leanmcu/Green-Pill-Nano-Hardware/green_pill_nano_pinout.png

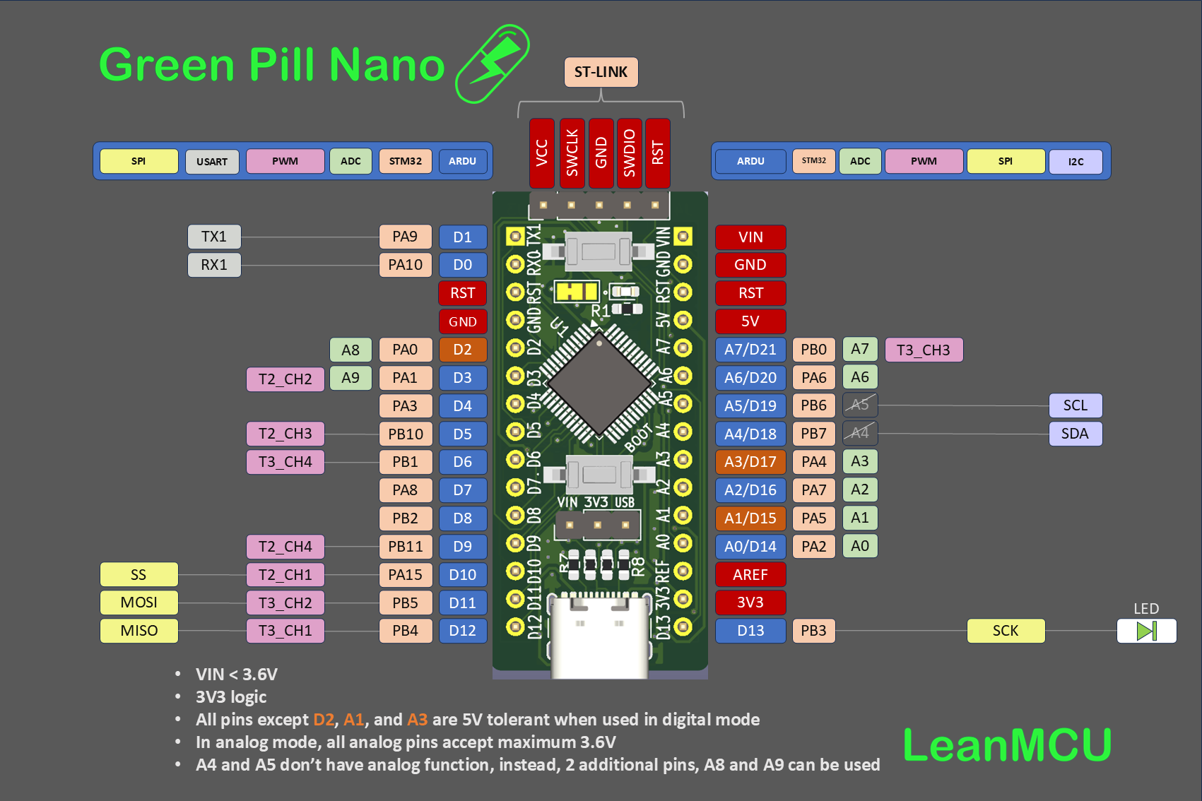
green_pill_nano_pinout.png
