leanmcu/Green-Pill-Nano-Hardware/green_pill_nano_schematic.pdf

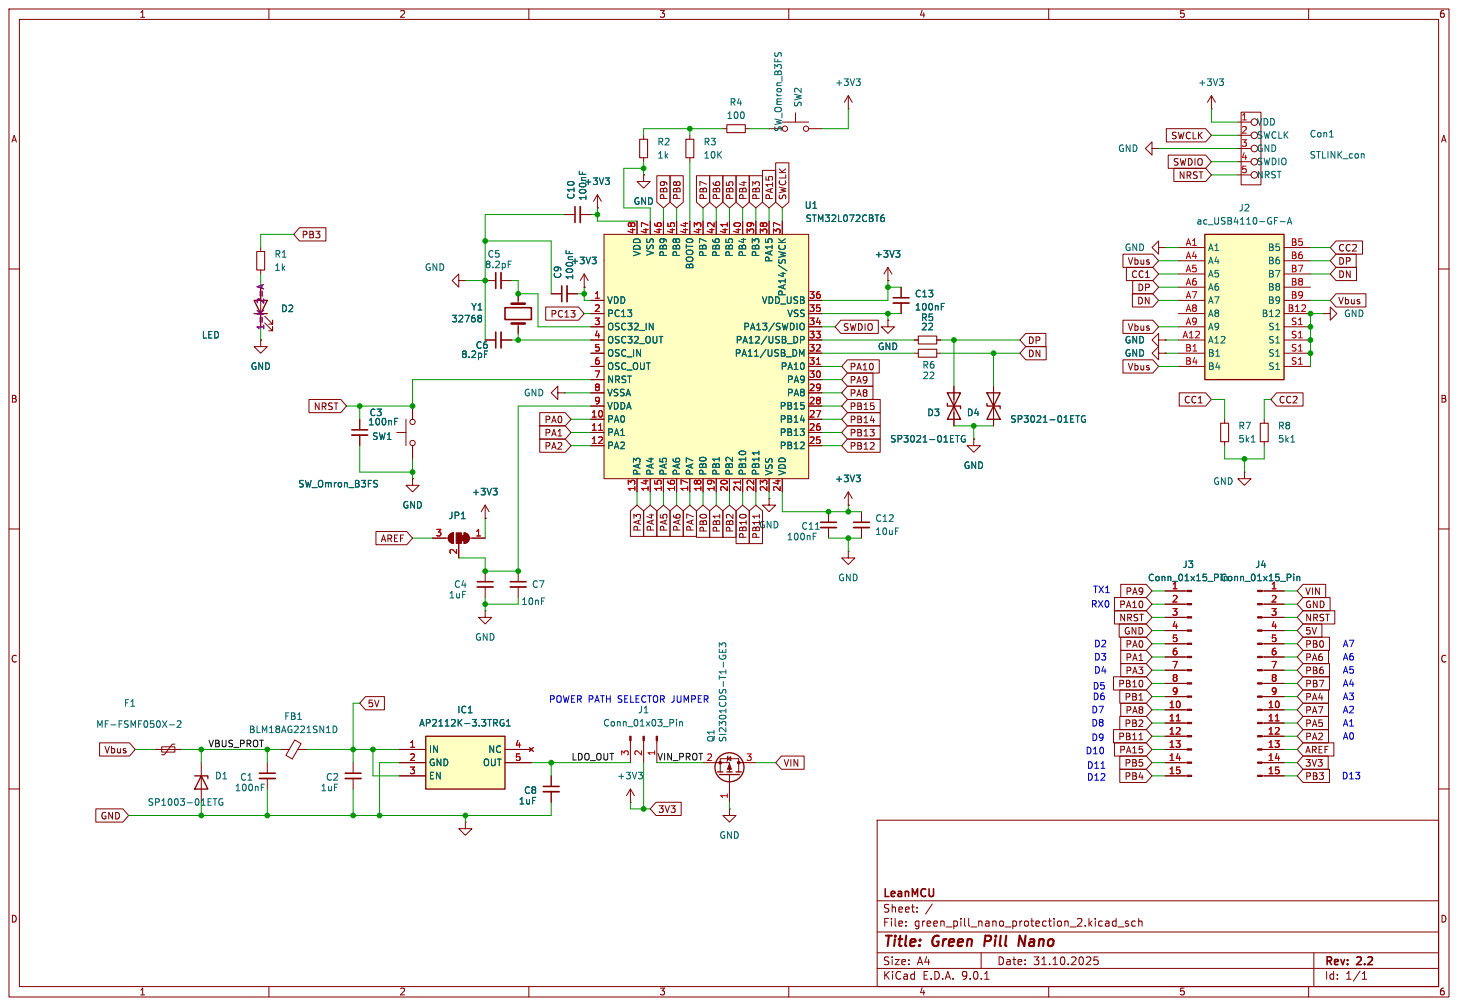
[picture p2: page 1]

Id: 1/1 Title: Green Pill Nano
