leanmcu/Green-Pill-Nano-Hardware/green_pill_nano_protection_2.kicad_sch

## KiCad design green_pill_nano_protection_2.kicad_sch (2026-01-22)

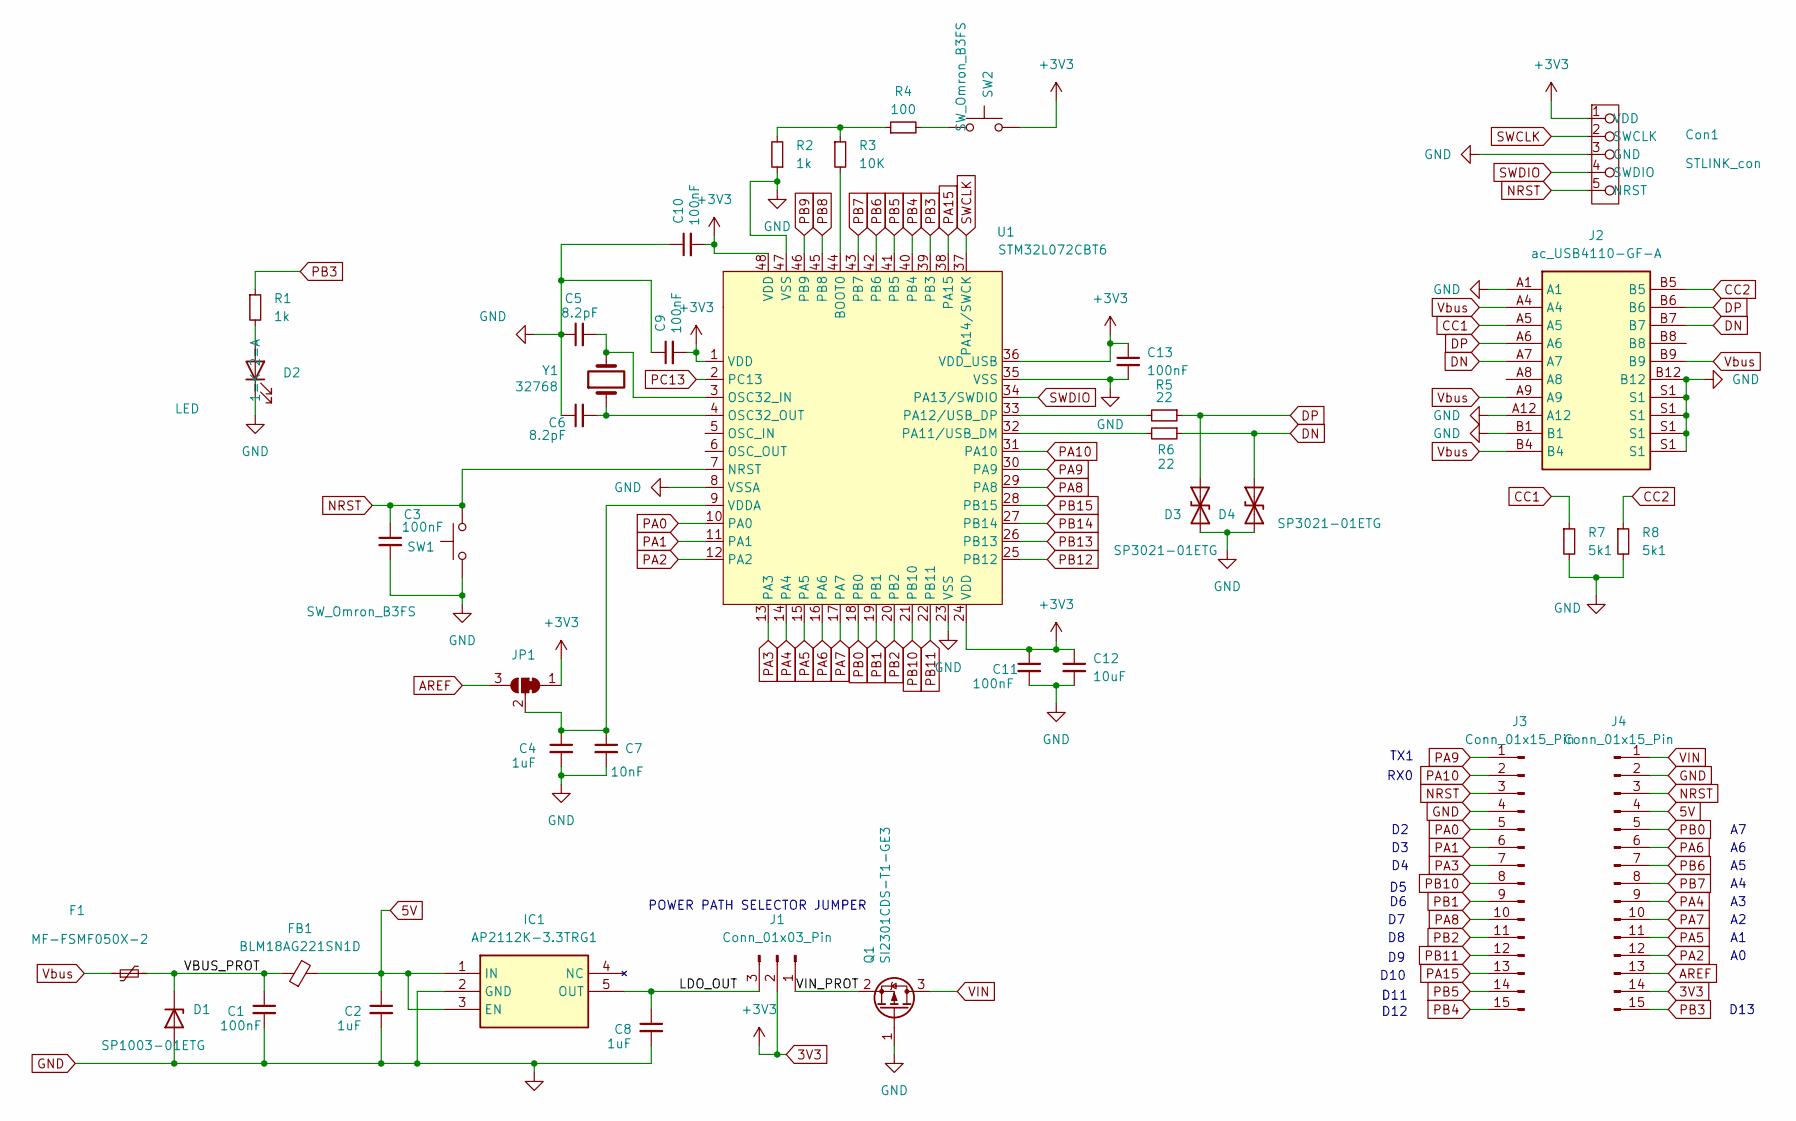
[picture p3: schematic green_pill_nano_protection_2.kicad_sch]

Parts:
C1, C3, C9, C10, C11, C13: 100nF; C_0603_1608Metric_Pad1.08x0.95mm_HandSolder
C2, C4, C8: 1uF; C_0603_1608Metric_Pad1.08x0.95mm_HandSolder
C5, C6: 8.2pF; C_0603_1608Metric_Pad1.08x0.95mm_HandSolder
C7: 10nF; C_0603_1608Metric_Pad1.08x0.95mm_HandSolder
C12: 10uF; C_0603_1608Metric_Pad1.08x0.95mm_HandSolder
Con1: STLINK_con; ac_PinHeader_1x05_P2.54mm_Vertical
D1: SP1003-01ETG; D_SOD-882
D2: LED; LED_0603_1608Metric
D3, D4: SP3021-01ETG; D_SOD-882
F1: MF-FSMF050X-2; R_0603_1608Metric_Pad0.98x0.95mm_HandSolder
FB1: BLM18AG221SN1D; R_0603_1608Metric_Pad0.98x0.95mm_HandSolder
IC1: AP2112K-3.3TRG1; SOT-23-5; Mouser Part Number 595-TPS7A0233PDBVR
J1: Conn_01x03_Pin; PinHeader_1x03_P2.54mm_Vertical
J2: ac_USB4110-GF-A; USB_C_Receptacle_GCT_USB4105-xx-A_16P_TopMnt_Horizontal; Mouser Part Number 640-USB4110-GF-A
J3, J4: Conn_01x15_Pin; PinHeader_1x15_P2.54mm_Vertical
JP1: SolderJumper_3_Bridged12; SolderJumper-3_P1.3mm_Bridged12_Pad1.0x1.5mm_NumberLabels
Q1: SI2301CDS-T1-GE3; SOT-23
R1, R2: 1k; R_0603_1608Metric_Pad0.98x0.95mm_HandSolder
R3: 10K; R_0603_1608Metric_Pad0.98x0.95mm_HandSolder
R4: 100; R_0603_1608Metric_Pad0.98x0.95mm_HandSolder
R5, R6: 22; R_0603_1608Metric_Pad0.98x0.95mm_HandSolder
R7, R8: 5k1; R_0603_1608Metric_Pad0.98x0.95mm_HandSolder
SW1, SW2: SW_Omron_B3FS; ac_tactile_switch_PTS636SP50SMTRLFS
U1: STM32L072CBT6; LQFP-48_7x7mm_P0.5mm
Y1: 32768; ac_quartz_FC135327680KAAG0

Connections:
5V: C2.1, FB1.2, IC1.1 (IN), IC1.3 (EN), J4.4
+3V3: C9.2, C10.2, C11.1, C12.1, C13.1, Con1.1 (VDD), J1.2, J4.14, JP1.1 (A), SW2.2, U1.1 (VDD), U1.24 (VDD), U1.36 (VDD_USB), U1.48 (VDD)
AREF: J4.13, JP1.3 (B)
CC1: J2.A5, R7.1
CC2: J2.B5, R8.1
DN: D4.1 (A1), J2.A7, J2.B7, R6.1
DP: D3.1 (A1), J2.A6, J2.B6, R5.1
GND: C1.2, C2.2, C3.2, C4.2, C5.1, C6.1, C7.2, C8.2, C9.1, C10.1, C11.2, C12.2, C13.2, Con1.3 (GND), D1.2 (A), D2.1 (K), D3.2 (A2), D4.2 (A2), IC1.2 (GND), J2.A1, J2.A12, J2.B1, J2.B12, J2.S1, J3.4, J4.2, Q1.1 (G), R2.1, R7.2, R8.2, SW1.1, U1.8 (VSSA), U1.23 (VSS), U1.35 (VSS), U1.47 (VSS)
LDO_OUT: C8.1, IC1.5 (OUT), J1.3
NRST: C3.1, Con1.5 (NRST), J3.3, J4.3, SW1.2, U1.7 (NRST)
unnamed: C4.1, C7.1, JP1.2 (C), U1.9 (VDDA)
unnamed: C5.2, U1.3 (OSC32_IN), Y1.2
unnamed: C6.2, U1.4 (OSC32_OUT), Y1.1
unnamed: D2.2 (A), R1.2
unnamed: R2.2, R3.1, R4.1
unnamed: R3.2, U1.44 (BOOT0)
unnamed: R4.2, SW2.1
unnamed: R5.2, U1.33 (PA12/USB_DP)
unnamed: R6.2, U1.32 (PA11/USB_DM)
PA0: J3.5, U1.10 (PA0)
PA1: J3.6, U1.11 (PA1)
PA2: J4.12, U1.12 (PA2)
PA3: J3.7, U1.13 (PA3)
PA4: J4.9, U1.14 (PA4)
PA5: J4.11, U1.15 (PA5)
PA6: J4.6, U1.16 (PA6)
PA7: J4.10, U1.17 (PA7)
PA8: J3.10, U1.29 (PA8)
PA9: J3.1, U1.30 (PA9)
PA10: J3.2, U1.31 (PA10)
PA15: J3.13, U1.38 (PA15)
PB0: J4.5, U1.18 (PB0)
PB1: J3.9, U1.19 (PB1)
PB2: J3.11, U1.20 (PB2)
PB3: J4.15, R1.1, U1.39 (PB3)
PB4: J3.15, U1.40 (PB4)
PB5: J3.14, U1.41 (PB5)
PB6: J4.7, U1.42 (PB6)
PB7: J4.8, U1.43 (PB7)
PB8: U1.45 (PB8)
PB9: U1.46 (PB9)
PB10: J3.8, U1.21 (PB10)
PB11: J3.12, U1.22 (PB11)
PB12: U1.25 (PB12)
PB13: U1.26 (PB13)
PB14: U1.27 (PB14)
PB15: U1.28 (PB15)
PC13: U1.2 (PC13)
SWCLK: Con1.2 (SWCLK), U1.37 (PA14/SWCK)
SWDIO: Con1.4 (SWDIO), U1.34 (PA13/SWDIO)
VBUS_PROT: C1.1, D1.1 (K), F1.2, FB1.1
VIN: J4.1, Q1.3 (D)
VIN_PROT: J1.1, Q1.2 (S)
Vbus: F1.1, J2.A4, J2.A9, J2.B4, J2.B9

Notes on the sheet:
TX1
D11
D13
RX0
D10
D12
POWER PATH SELECTOR JUMPER
